FatimaSarwarA/Indigenous-Line-Follower/Sim with line following (w 74123)_final.PDF

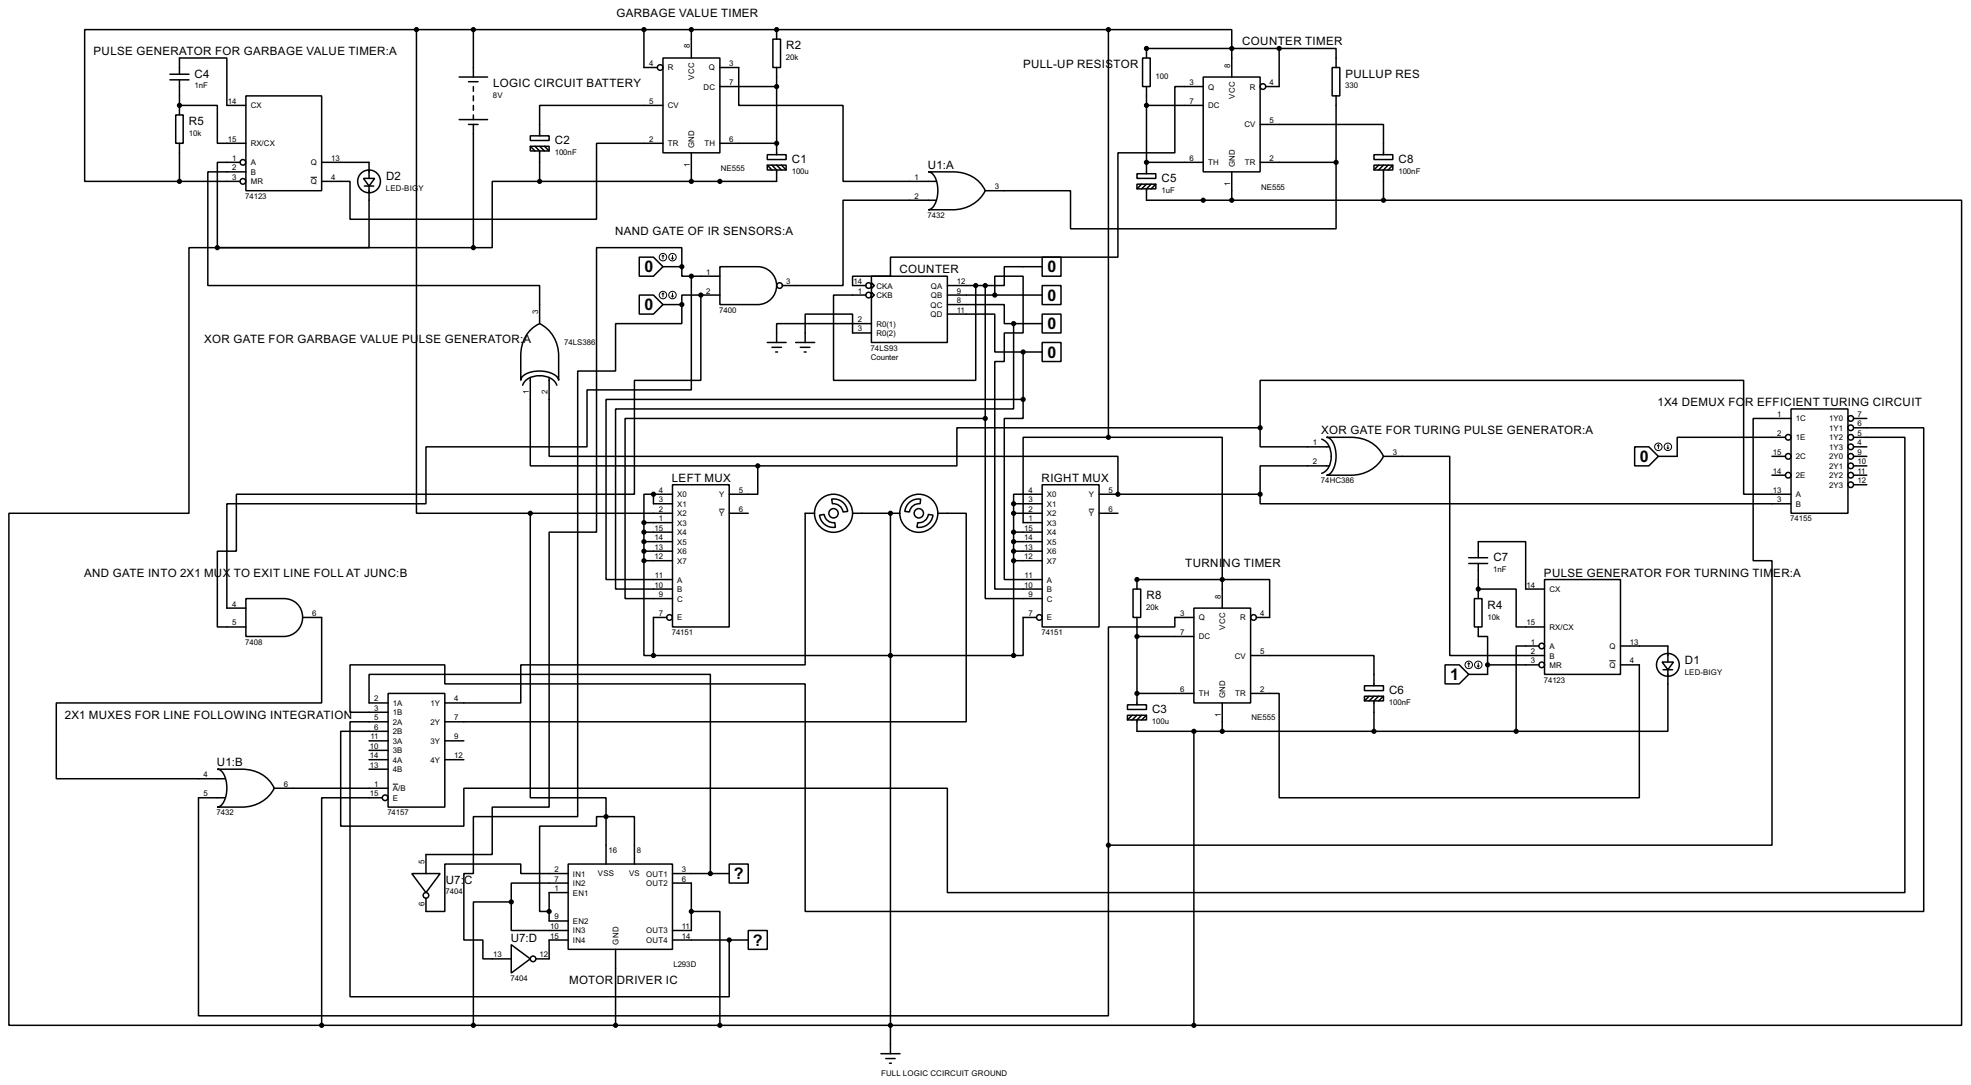
[picture p10: page 1]

PULSE GENERATOR FOR GARBAGE VALUE TIMER:A

NAND GATE OF IR SENSORS:A

1X4 DEMUX FOR EFFICIENT TURING CIRCUIT

3 XOR GATE FOR TURING PULSE GENERATOR:A

AND GATE INTO 2X1 MUX TO EXIT LINE FOLL AT JUNC:B

PULSE GENERATOR FOR TURNING TIMER:A

2X1 MUXES FOR LINE FOLLOWING INTEGRATION

11
10 | 12

7 | IN2 EN1 EN2 IN3 OUT3 IN4 | 6
1 | | 11 OUT4

FULL LOGIC CCIRCUIT GROUND
