FatimaSarwarA/Indigenous-Line-Follower/(list of files, drawings)

Other design files:
Sim with line following (w 74123)_final.pdsprj
